bossersimon/stm32-audio-DSP/documents/86AjS.png

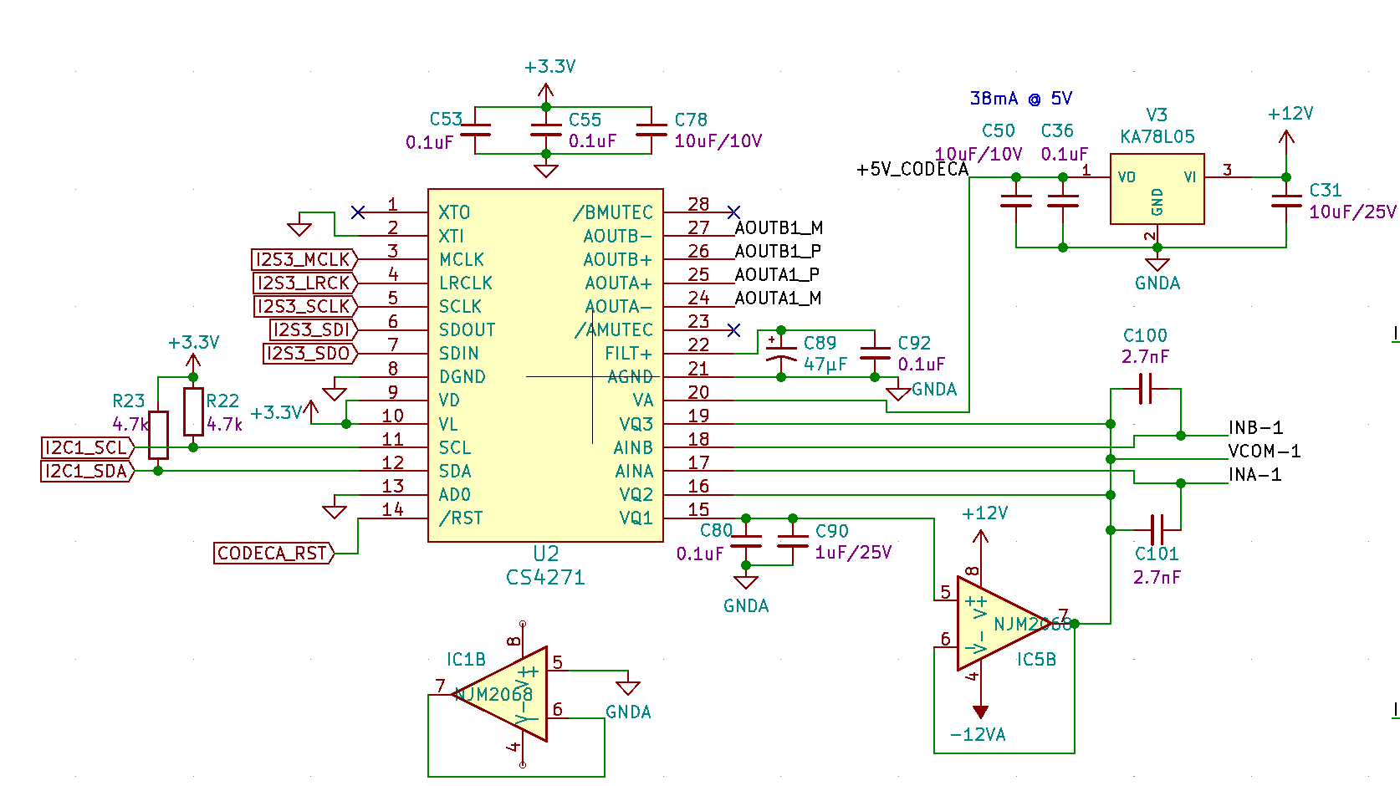
documents/86AjS.png
