bossersimon/stm32-audio-DSP/kicad/first.kicad_pcb

## KiCad design kicad/first.kicad_pcb (2026-11-02)

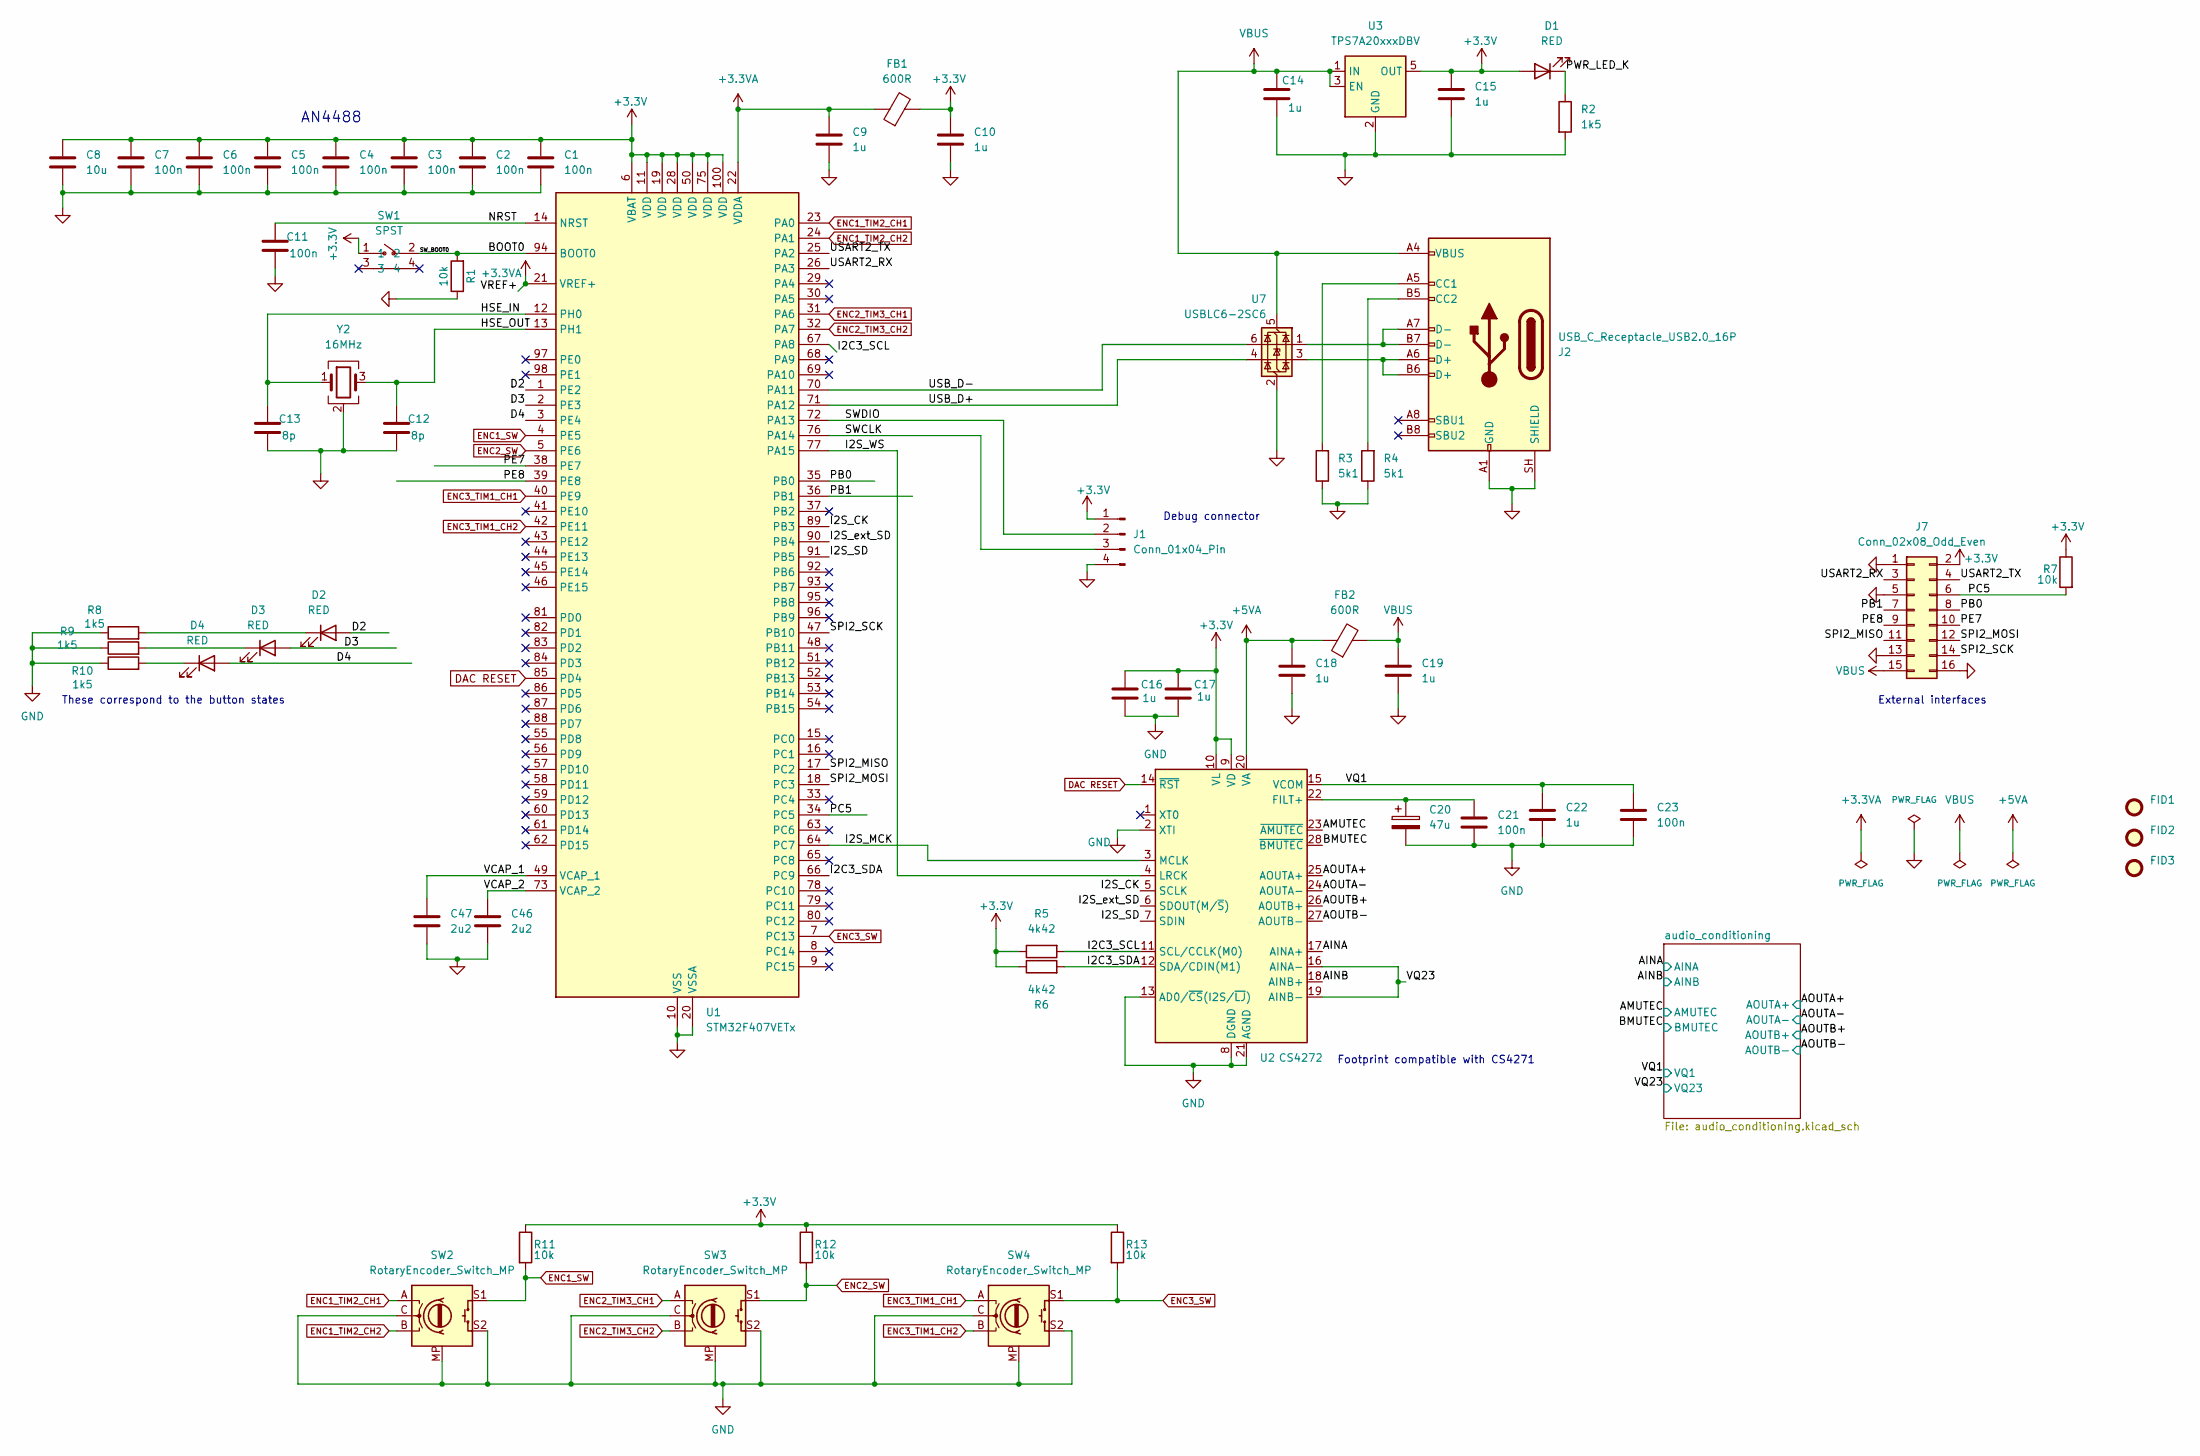
[picture p2: schematic first.kicad_sch]

Parts:
C1, C2, C3, C4, C5, C6, C7, C11, C21, C23: 100n; C_0402_1005Metric
C8: 10u; C_0603_1608Metric
C9, C10, C14, C15, C16, C17, C18, C19, C22: 1u; C_0402_1005Metric
C12, C13: 8p; C_0402_1005Metric
C20: 47u; CP_Elec_4x5.4
C46, C47: 2u2; C_0402_1005Metric
D1, D2, D3, D4: RED; LED_0603_1608Metric
FB1, FB2: 600R; L_0603_1608Metric
FID1, FID2, FID3: Fiducial; Fiducial_1mm_Mask3mm
J1: Conn_01x04_Pin; PinHeader_1x04_P2.54mm_Vertical
J2: USB_C_Receptacle_USB2.0_16P; USB_C_Receptacle_G-Switch_GT-USB-7010ASV
J7: Conn_02x08_Odd_Even; PinHeader_2x08_P2.54mm_Vertical
R1, R7, R11, R12, R13: 10k; R_0402_1005Metric
R2, R8, R9, R10: 1k5; R_0402_1005Metric
R3, R4: 5k1; R_0402_1005Metric
R5, R6: 4k42; R_0402_1005Metric
SW1: SPST; SW-SMD_TC-S3601-3.5-260G-F0.6; MPN TC-S3601-3.5-260G-F0.6; LCSC Part C49101620
SW2, SW3, SW4: RotaryEncoder_Switch_MP; RotaryEncoder_Alps_EC11E-Switch_Vertical_H20mm
U1: STM32F407VETx; LQFP-100_14x14mm_P0.5mm
U2: CS4272; TSSOP-28_4.4x9.7mm_P0.65mm
U3: TPS7A20xxxDBV; SOT-23-5
U7: USBLC6-2SC6; SOT-23-6
Y2: 16MHz; Crystal_SMD_3225-4Pin_3.2x2.5mm

Connections:
+3.3V: C1.1, C2.1, C3.1, C4.1, C5.1, C6.1, C7.1, C8.1, C10.1, C15.1, C16.1, C17.1, D1.2 (A), FB1.2, J1.1, J7.2, R5.1, R6.1, R7.1, R11.1, R12.1, R13.1, SW1.1, U1.6 (VBAT), U1.11 (VDD), U1.19 (VDD), U1.28 (VDD), U1.50 (VDD), U1.75 (VDD), U1.100 (VDD), U2.9 (VD), U2.10 (VL), U3.5 (OUT)
+3.3VA: C9.1, FB1.1, U1.21 (VREF+), U1.22 (VDDA)
+5VA: C18.1, FB2.1, U2.20 (VA); also elsewhere on the board
/AINA: U2.17 (AINA+); also elsewhere on the board
/AINB: U2.18 (AINB+); also elsewhere on the board
/AMUTEC: U2.23 (~AMUTEC); also elsewhere on the board
/AOUTA+: U2.25 (AOUTA+); also elsewhere on the board
/AOUTA-: U2.24 (AOUTA-); also elsewhere on the board
/AOUTB+: U2.26 (AOUTB+); also elsewhere on the board
/AOUTB-: U2.27 (AOUTB-); also elsewhere on the board
/BMUTEC: U2.28 (~BMUTEC); also elsewhere on the board
/BOOT0: R1.2, SW1.2, U1.94 (BOOT0)
/D2: D2.2 (A), U1.1 (PE2)
/D3: D3.2 (A), U1.2 (PE3)
/D4: D4.2 (A), U1.3 (PE4)
/HSE_IN: C13.1, U1.12 (PH0), Y2.1
/HSE_OUT: C12.1, U1.13 (PH1), Y2.3
/I2C3_SCL: R5.2, U1.67 (PA8), U2.11 (SCL/CCLK(M0))
/I2C3_SDA: R6.2, U1.66 (PC9), U2.12 (SDA/CDIN(M1))
/I2S_CK: U1.89 (PB3), U2.5 (SCLK)
/I2S_MCK: U1.64 (PC7), U2.3 (MCLK)
/I2S_SD: U1.91 (PB5), U2.7 (SDIN)
/I2S_WS: U1.77 (PA15), U2.4 (LRCK)
/I2S_ext_SD: U1.90 (PB4), U2.6 (SDOUT(M/~S))
/NRST: C11.1, U1.14 (NRST)
/PB0: J7.8, U1.35 (PB0)
/PB1: J7.7, U1.36 (PB1)
/PC5: J7.6, R7.2, U1.34 (PC5)
/PE7: J7.10, U1.38 (PE7)
/PE8: J7.9, U1.39 (PE8)
/PWR_LED_K: D1.1 (K), R2.1
/SPI2_MISO: J7.11, U1.17 (PC2)
/SPI2_MOSI: J7.12, U1.18 (PC3)
/SPI2_SCK: J7.14, U1.47 (PB10)
/SWCLK: J1.3, U1.76 (PA14)
/SWDIO: J1.2, U1.72 (PA13)
/USART2_RX: J7.3, U1.26 (PA3)
/USART2_TX: J7.4, U1.25 (PA2)
/USB_D+: U1.71 (PA12), U7.4 (I/O2)
/USB_D-: U1.70 (PA11), U7.6 (I/O1)
/VCAP_1: C47.2, U1.49 (VCAP_1)
/VCAP_2: C46.2, U1.73 (VCAP_2)
/VQ1: C22.1, C23.1, U2.15 (VCOM); also elsewhere on the board
/VQ23: U2.16 (AINA-), U2.19 (AINB-); also elsewhere on the board
DAC RESET: U1.85 (PD4), U2.14 (~RST)
ENC1_SW: R11.2, SW2.S1, U1.4 (PE5)
ENC1_TIM2_CH1: SW2.A, U1.23 (PA0)
ENC1_TIM2_CH2: SW2.B, U1.24 (PA1)
ENC2_SW: R12.2, SW3.S1, U1.5 (PE6)
ENC2_TIM3_CH1: SW3.A, U1.31 (PA6)
ENC2_TIM3_CH2: SW3.B, U1.32 (PA7)
ENC3_SW: R13.2, SW4.S1, U1.7 (PC13)
ENC3_TIM1_CH1: SW4.A, U1.40 (PE9)
ENC3_TIM1_CH2: SW4.B, U1.42 (PE11)
GND: C1.2, C2.2, C3.2, C4.2, C5.2, C6.2, C7.2, C8.2, C9.2, C10.2, C11.2, C12.2, C13.2, C14.2, C15.2, C16.2, C17.2, C18.2, C19.2, C20.2, C21.2, C22.2, C23.2, C46.1, C47.1, J1.4, J2.A1 (GND), J2.A12 (GND), J2.B1 (GND), J2.B12 (GND), J2.SH (SHIELD), J7.1, J7.5, J7.13, J7.16, R1.1, R2.2, R3.1, R4.1, R8.1, R9.1, R10.1, SW2.C, SW2.MP, SW2.S2, SW3.C, SW3.MP, SW3.S2, SW4.C, SW4.MP, SW4.S2, U1.10 (VSS), U1.20 (VSSA), U1.27 (VSS), U1.74 (VSS), U1.99 (VSS), U2.2 (XTI), U2.8 (DGND), U2.13 (AD0/~CS(I2S/~LJ)), U2.21 (AGND), U3.2 (GND), U7.2 (GND), Y2.2 (G), Y2.4 (G); also elsewhere on the board
unnamed: D2.1 (K), R8.2
unnamed: D3.1 (K), R9.2
unnamed: D4.1 (K), R10.2
unnamed: J2.A5 (CC1), R3.2
unnamed: J2.B5 (CC2), R4.2
unnamed: J2.A6 (D+), J2.B6 (D+), U7.3 (I/O2)
unnamed: J2.A7 (D-), J2.B7 (D-), U7.1 (I/O1)
unnamed: C20.1, C21.1, U2.22 (FILT+)
VBUS: C14.1, C19.1, FB2.2, J2.A4 (VBUS), J2.A9 (VBUS), J2.B4 (VBUS), J2.B9 (VBUS), J7.15, U3.1 (IN), U3.3 (EN), U7.5 (VBUS)

Notes on the sheet:
AN4488
These correspond to the button states
Footprint compatible with CS4271
Debug connector
External interfaces

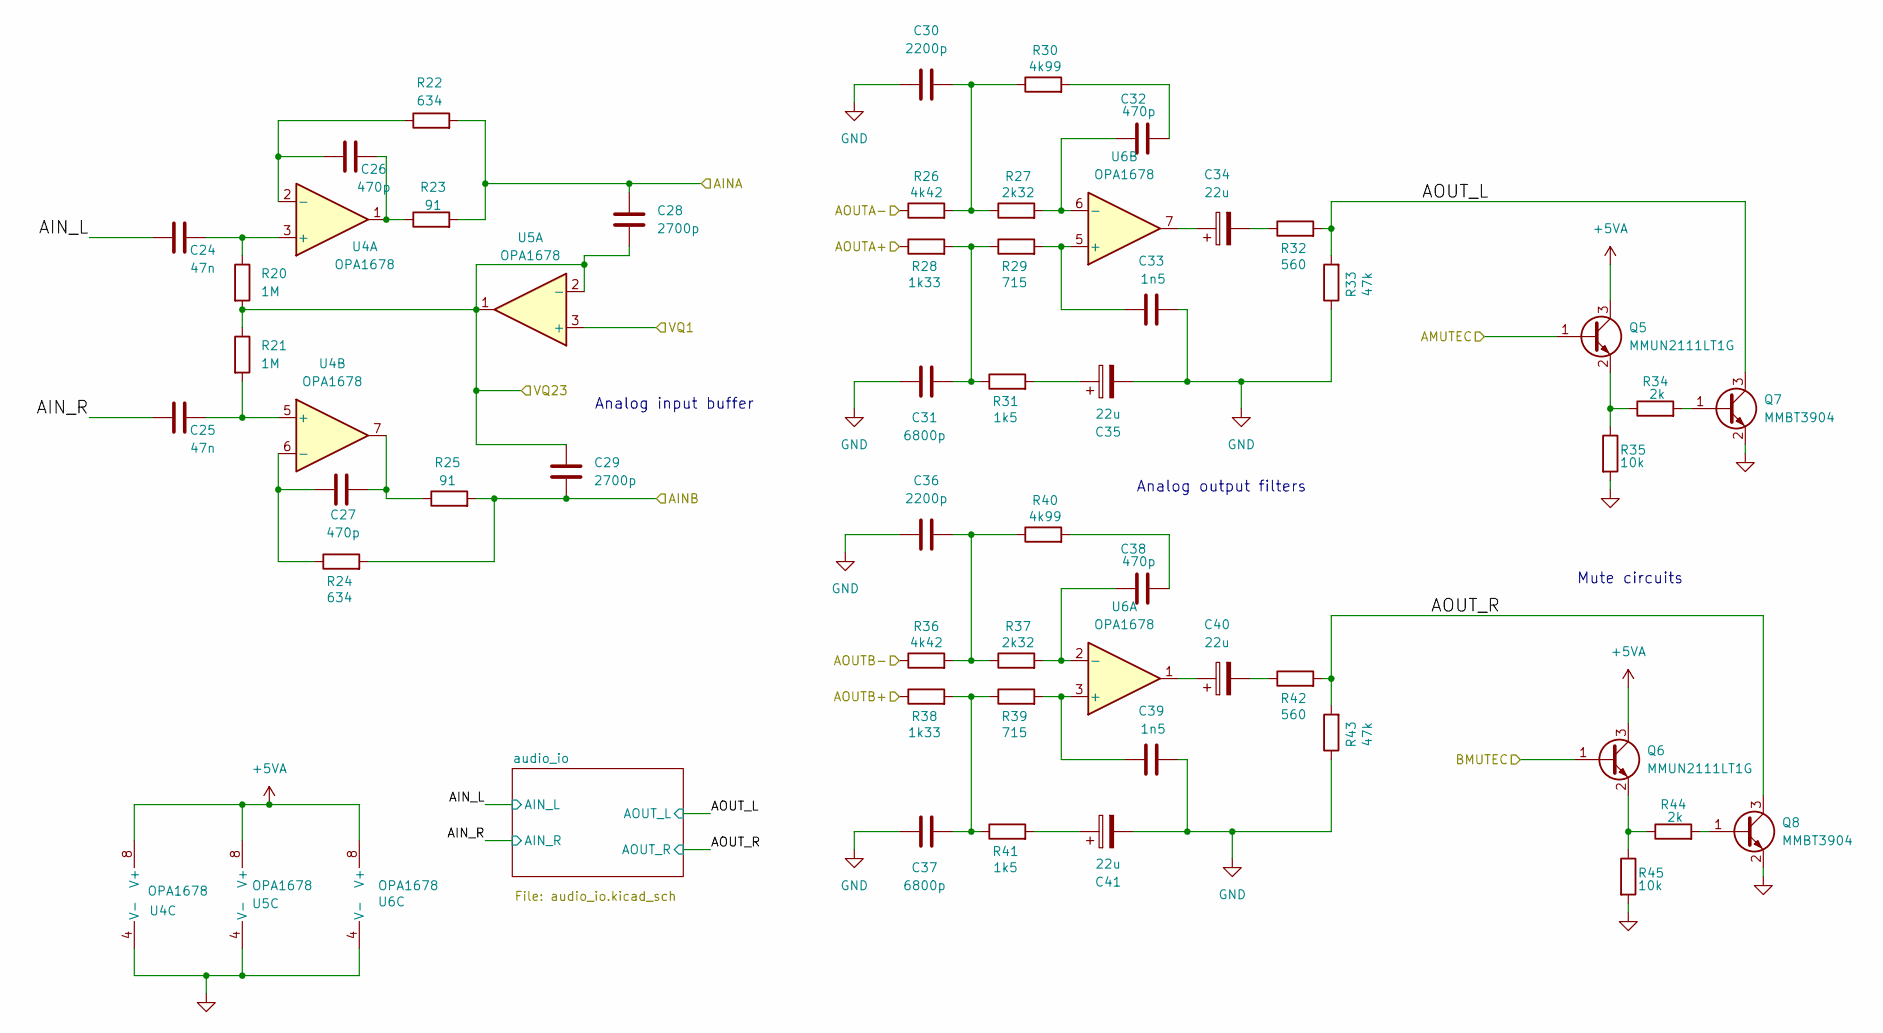
[picture p3: schematic audio_conditioning.kicad_sch]

Parts:
C24, C25: 47n; C_0805_2012Metric
C26, C27, C32, C38: 470p; C_0402_1005Metric
C28, C29: 2700p; C_0603_1608Metric
C30, C36: 2200p; C_0603_1608Metric
C31, C37: 6800p; C_0603_1608Metric
C33, C39: 1n5; C_0603_1608Metric
C34, C35, C40, C41: 22u; CP_Elec_4x5.4
Q5, Q6: MMUN2111LT1G; SOT-23
Q7, Q8: MMBT3904; SOT-23
R20, R21: 1M; R_0402_1005Metric
R22, R24: 634; R_0402_1005Metric
R23, R25: 91; R_0402_1005Metric
R26, R36: 4k42; R_0402_1005Metric
R27, R37: 2k32; R_0402_1005Metric
R28, R38: 1k33; R_0402_1005Metric
R29, R39: 715; R_0402_1005Metric
R30, R40: 4k99; R_0402_1005Metric
R31, R41: 1k5; R_0402_1005Metric
R32, R42: 560; R_0402_1005Metric
R33, R43: 47k; R_0402_1005Metric
R34, R44: 2k; R_0402_1005Metric
R35, R45: 10k; R_0402_1005Metric
U4, U5, U6: OPA1678; SOIC-8_3.9x4.9mm_P1.27mm

Connections:
+5VA: Q5.3 (C), Q6.3 (C), U4.8 (V+), U5.8 (V+), U6.8 (V+); also elsewhere on the board
/AINA: C28.1, R22.2, R23.2; also elsewhere on the board
/AINB: C29.2, R24.2, R25.2; also elsewhere on the board
/AMUTEC: Q5.1 (B); also elsewhere on the board
/AOUTA+: R28.1; also elsewhere on the board
/AOUTA-: R26.1; also elsewhere on the board
/AOUTB+: R38.1; also elsewhere on the board
/AOUTB-: R36.1; also elsewhere on the board
/BMUTEC: Q6.1 (B); also elsewhere on the board
/VQ1: U5.3 (+); also elsewhere on the board
/VQ23: C28.2, C29.1, R20.2, R21.1, U5.1, U5.2 (-); also elsewhere on the board
/audio_conditioning/AIN_L: C24.2; also elsewhere on the board
/audio_conditioning/AIN_R: C25.2; also elsewhere on the board
/audio_conditioning/AOUT_L: Q7.3 (C), R32.2, R33.2; also elsewhere on the board
/audio_conditioning/AOUT_R: Q8.3 (C), R42.2, R43.2; also elsewhere on the board
GND: C30.2, C31.2, C33.1, C35.2, C36.2, C37.2, C39.1, C41.2, Q7.2 (E), Q8.2 (E), R33.1, R35.2, R43.1, R45.2, U4.4 (V-), U5.4 (V-), U6.4 (V-); also elsewhere on the board
unnamed: C26.1, R23.1, U4.1
unnamed: C27.1, R25.1, U4.7
unnamed: C30.1, R26.2, R27.1, R30.1
unnamed: C31.1, R28.2, R29.1, R31.1
unnamed: C32.1, R30.2
unnamed: C34.1, U6.7
unnamed: C34.2, R32.1
unnamed: C35.1, R31.2
unnamed: C36.1, R36.2, R37.1, R40.1
unnamed: C37.1, R38.2, R39.1, R41.1
unnamed: C38.1, R40.2
unnamed: C40.1, U6.1
unnamed: C40.2, R42.1
unnamed: C41.1, R41.2
unnamed: Q5.2 (E), R34.1, R35.1
unnamed: Q6.2 (E), R44.1, R45.1
unnamed: Q7.1 (B), R34.2
unnamed: Q8.1 (B), R44.2
unnamed: C24.1, R20.1, U4.3 (+)
unnamed: C26.2, R22.1, U4.2 (-)
unnamed: C25.1, R21.2, U4.5 (+)
unnamed: C27.2, R24.1, U4.6 (-)
unnamed: C39.2, R39.2, U6.3 (+)
unnamed: C38.2, R37.2, U6.2 (-)
unnamed: C33.2, R29.2, U6.5 (+)
unnamed: C32.2, R27.2, U6.6 (-)

Notes on the sheet:
Analog output filters
Analog input buffer
Mute circuits

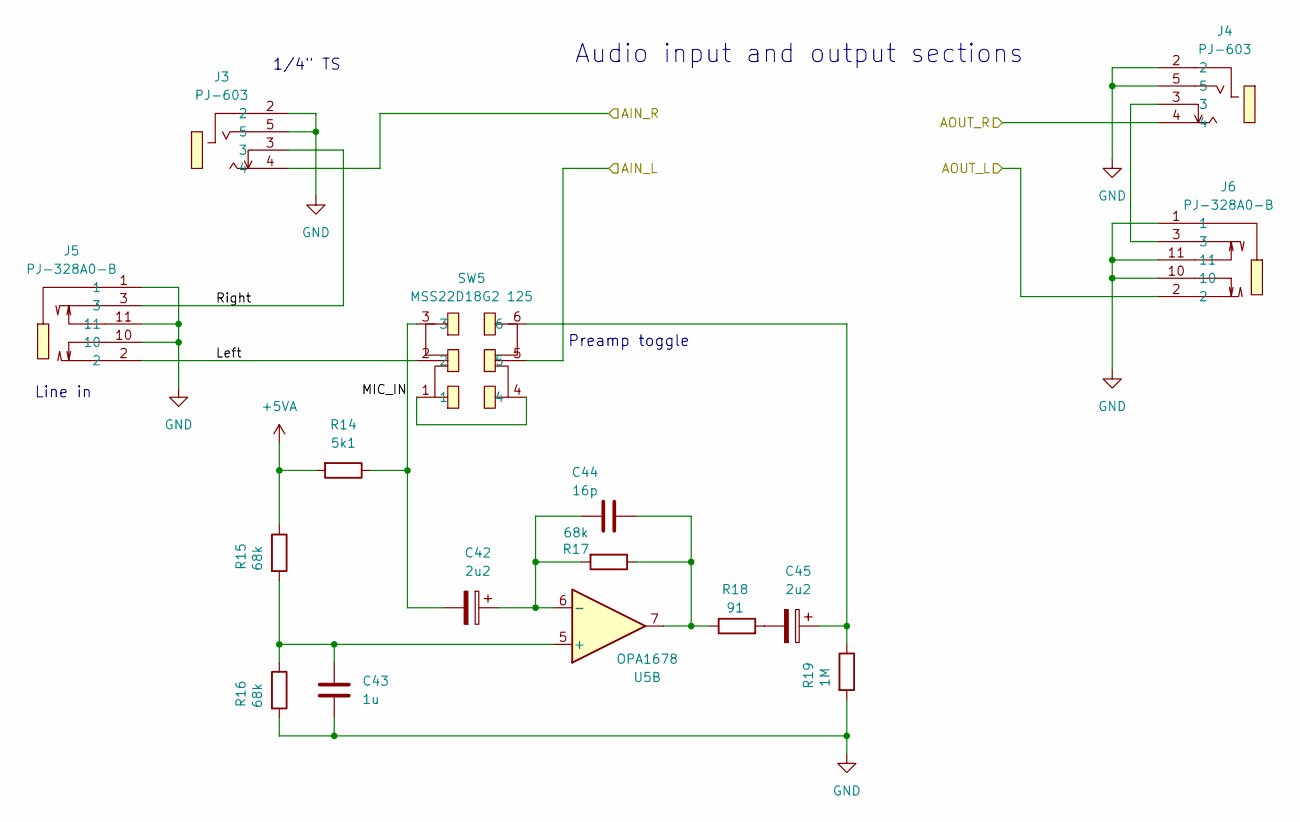
[picture p4: schematic audio_io.kicad_sch]

Parts:
C42, C45: 2u2; CP_Elec_4x5.4
C43: 1u; C_0402_1005Metric
C44: 16p; C_0402_1005Metric
J3, J4: PJ-603; AUDIO-TH_PJ-603; MPN PJ-603环保; LCSC Part C309272
J5, J6: PJ-328A0-B; AUDIO-TH_PJ-328A0-B; MPN PJ-328A0-B; LCSC Part C381129
R14: 5k1; R_0402_1005Metric
R15, R16, R17: 68k; R_0402_1005Metric
R18: 91; R_0402_1005Metric
R19: 1M; R_0402_1005Metric
SW5: MSS22D18G2 125; SW-TH_SHOU_MSS22D18G2; MPN MSS22D18G2 125; LCSC Part C2906278
U5: OPA1678; SOIC-8_3.9x4.9mm_P1.27mm

Connections:
+5VA: R14.2, R15.1; also elsewhere on the board
/audio_conditioning/AIN_L: SW5.5; also elsewhere on the board
/audio_conditioning/AIN_R: J3.4; also elsewhere on the board
/audio_conditioning/AOUT_L: J6.2; also elsewhere on the board
/audio_conditioning/AOUT_R: J4.4; also elsewhere on the board
/audio_conditioning/audio_io/Left: J5.2, SW5.2
/audio_conditioning/audio_io/MIC_IN: C42.2, R14.1, SW5.3
/audio_conditioning/audio_io/Right: J3.3, J5.3
GND: C43.2, J3.2, J3.5, J4.2, J4.5, J5.1, J5.10, J5.11, J6.1, J6.10, J6.11, R16.2, R19.2; also elsewhere on the board
unnamed: C44.2, R17.1, R18.1, U5.7
unnamed: C45.1, R19.1, SW5.6
unnamed: C45.2, R18.2
unnamed: J4.3, J6.3
unnamed: SW5.1, SW5.4
unnamed: C43.1, R15.2, R16.1, U5.5 (+)
unnamed: C42.1, C44.1, R17.2, U5.6 (-)

Notes on the sheet:
Preamp toggle
Audio input and output sections
1/4" TS
Line in

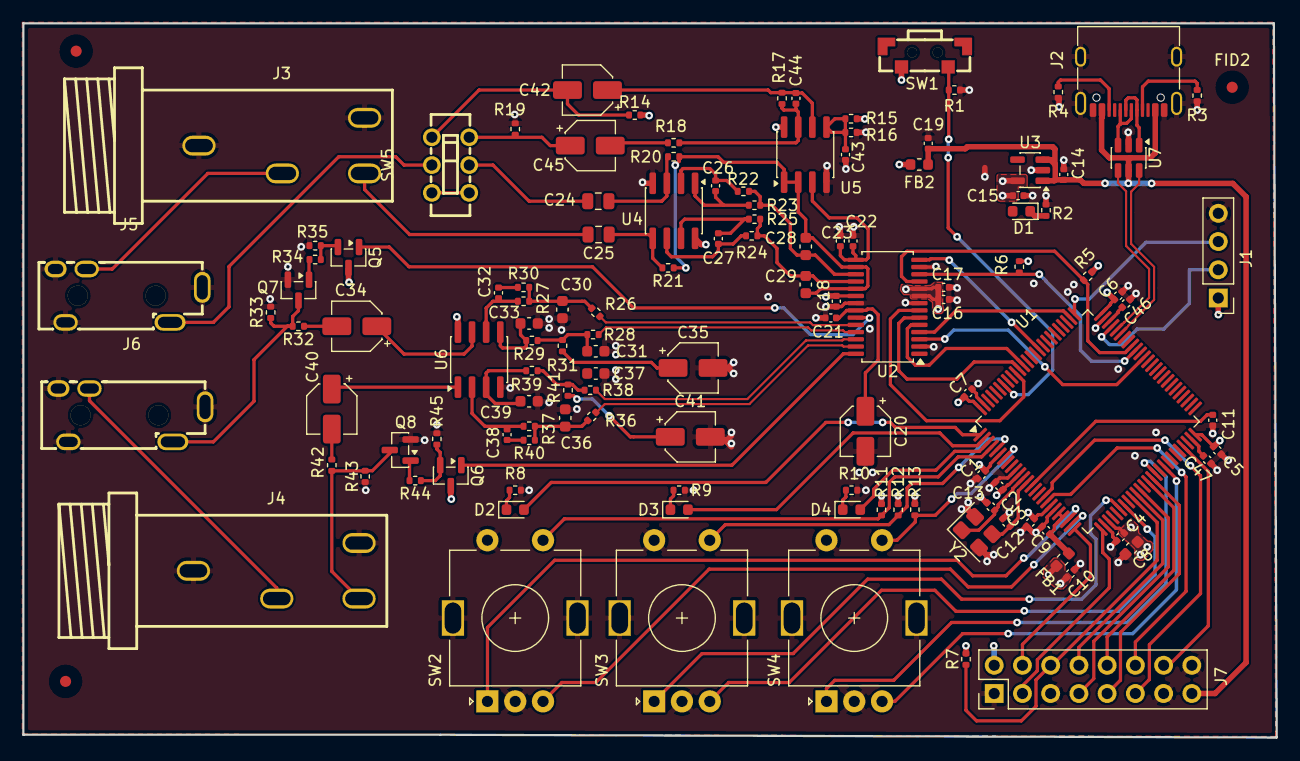
[picture p5: board first.kicad_pcb from above]

Board: 4 copper layers, 112.8 x 64.2 mm, 125 parts (0 on the bottom side), 104 nets.
