bossersimon/stm32-audio-DSP/Core/Src/main.c

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
/* Includes ------------------------------------------------------------------*/
#include "main.h"
#include "usb_device.h"

/* USER CODE BEGIN Includes */
#include "math.h"
#include <stdint.h>
#include "audio_sample.c"
/* USER CODE END Includes */

/* USER CODE BEGIN PD */
#define BUFFER_SIZE 128 // double buffer size
#define CAPACITY 1024   // circular buffer size
#define WINDOW_SIZE 256 // FFT size
#define AUDIO_SMPLRT 48000 // audio sample rate (temporary)
#define DAC_ADDR (0x4AU << 1)

#ifndef M_PI
#    define M_PI 3.14159265358979323846
#endif
/* USER CODE END PD */

ADC_HandleTypeDef hadc1;

I2C_HandleTypeDef hi2c1;
I2C_HandleTypeDef hi2c2;

I2S_HandleTypeDef hi2s3;
DMA_HandleTypeDef hdma_spi3_tx;

SPI_HandleTypeDef hspi2;

TIM_HandleTypeDef htim2;
TIM_HandleTypeDef htim3;
TIM_HandleTypeDef htim4;

UART_HandleTypeDef huart3;

/* USER CODE BEGIN PV */
//int16_t adcData[BUFFER_SIZE]; // buffers to hold DMA read/writes
int16_t dacData[BUFFER_SIZE];
//static volatile int16_t *adcBufPtr; // pointers for DMA
static volatile int16_t *dacBufPtr = &dacData[0];

static float phase; // generated sinusoid phase variable
static float dp;

static int16_t inBuf[CAPACITY];   // input/output circular buffers
static int16_t outBuf[CAPACITY];
uint8_t dataReadyFlag;

static volatile int16_t *inBufHead; // circular buffer pointers
static volatile int16_t *inBufTail;
static int16_t *inBufEnd;

static volatile int16_t *outBufHead;
static volatile int16_t *outBufTail;
static int16_t *outBufEnd;

static int inDataReadyFlag = 0;  // read/writes when there are enough samples in
static int outDataReadyFlag = 0; // the circular buffers

static uint16_t* audiosample = AUDIO_SAMPLE;
const size_t AUDIO_LENGTH = sizeof(AUDIO_SAMPLE) / sizeof(AUDIO_SAMPLE[0]);

/* USER CODE END PV */

void SystemClock_Config(void);
static void MX_GPIO_Init(void);
static void MX_DMA_Init(void);
static void MX_I2C1_Init(void);
static void MX_I2S3_Init(void);
static void MX_TIM2_Init(void);
static void MX_TIM3_Init(void);
static void MX_TIM4_Init(void);
static void MX_ADC1_Init(void);
static void MX_I2C2_Init(void);
static void MX_SPI2_Init(void);
static void MX_USART3_UART_Init(void);
/* USER CODE BEGIN PFP */
void process_block();
/* USER CODE END PFP */

/* USER CODE BEGIN 0 */

// half full
/*
void HAL_I2SEx_TxRxHalfCpltCallback(I2S_HandleTypeDef *hi2s) {

  adcBufPtr = &adcData[0];
  dacBufPtr = &dacData[0];

  dataReadyFlag = 1;
}
*/
// other half full
/*
void HAL_I2SEx_TxRxCpltCallback(I2S_HandleTypeDef *hi2s) {

    adcBufPtr = &adcData[BUFFER_SIZE/2];
    dacBufPtr = &dacData[BUFFER_SIZE/2];

    dataReadyFlag = 1;
}
*/
void HAL_I2S_TxCpltCallback(I2S_HandleTypeDef *hi2s) {
    //adcBufPtr = &adcData[BUFFER_SIZE/2];
    dacBufPtr = &dacData[BUFFER_SIZE/2];

    dataReadyFlag = 1;
}

void HAL_I2S_TxHalfCpltCallback(I2S_HandleTypeDef *hi2s) {
  //adcBufPtr = &adcData[0];
  dacBufPtr = &dacData[0];

  dataReadyFlag = 1;

}

void process_block() {

  static float leftIn, leftOut;
  static float rightIn, rightOut;

  if (audiosample >= (AUDIO_SAMPLE + AUDIO_LENGTH)) {
    audiosample = AUDIO_SAMPLE;
  }
  
  for(int i = 0; i < (BUFFER_SIZE/2); i += 2) {
    //leftIn = (float)adcBufPtr[i]/ 32767.0f;
    //rightIn = (float)adcBufPtr[i+1]/ 32767.0f;

    leftIn = audiosample[i];
    rightIn = audiosample[i+1];

    leftOut = leftIn;
    rightOut = rightIn;

    dacBufPtr[i] = leftOut;
    dacBufPtr[i+1] =  rightOut;
  }
  audiosample = audiosample + (BUFFER_SIZE/2);
  dataReadyFlag = 0;
}

/* USER CODE END 0 */

/**
  * @brief  The application entry point.
  * @retval int
  */
int main(void)
{

  /* MCU Configuration--------------------------------------------------------*/

  /* Reset of all peripherals, Initializes the Flash interface and the Systick. */
  HAL_Init();

  /* Configure the system clock */
  SystemClock_Config();

  /* Initialize all configured peripherals */
  MX_GPIO_Init();
  MX_DMA_Init();
  MX_I2C1_Init();
  MX_I2S3_Init();
  MX_USB_DEVICE_Init();
  MX_TIM2_Init();
  MX_TIM3_Init();
  MX_TIM4_Init();
  MX_ADC1_Init();
  MX_I2C2_Init();
  MX_SPI2_Init();
  MX_USART3_UART_Init();
  /* USER CODE BEGIN 2 */
  // starts I2S DMA streams
  //HAL_StatusTypeDef status = HAL_I2SEx_TransmitReceive_DMA(&hi2s3, (uint16_t *) dacData, (uint16_t *) NULL, BUFFER_SIZE);
  HAL_StatusTypeDef status = HAL_I2S_Transmit_DMA(&hi2s3, (uint16_t*)dacData, BUFFER_SIZE);
  uint16_t freq = 1000; // generated frequency
  dp = 2.0 * M_PI * 1000 / AUDIO_SMPLRT;
  phase = 0;
  
  cs43l22_Init(DAC_ADDR, OUTPUT_DEVICE_AUTO, 80, AUDIO_SMPLRT);
  cs43l22_Play(DAC_ADDR, NULL, 0);
  /* USER CODE END 2 */

  /* Infinite loop */
  /* USER CODE BEGIN WHILE */
  while (1)
  {
    /* USER CODE END WHILE */

    /* USER CODE BEGIN 3 */
  }
  /* USER CODE END 3 */
}

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
