bossersimon/stm32-audio-DSP/audioDSP.ioc

Mcu.UserName=STM32F407VGTx
PA0-WKUP.Signal=S_TIM2_CH1_ETR
PA1.Signal=S_TIM2_CH2
PA11.Signal=USB_OTG_FS_DM
PA12.Signal=USB_OTG_FS_DP
PA13.Signal=SYS_JTMS-SWDIO
PA14.Signal=SYS_JTCK-SWCLK
PA15.Signal=I2S3_WS
PA2.GPIO_Label=ENC1_SW
PA2.Signal=GPIO_Input
PA5.GPIO_Label=ENC2_SW
PA5.Signal=GPIO_Input
PA6.Signal=S_TIM3_CH1
PA7.Signal=S_TIM3_CH2
PA9.Signal=USB_OTG_FS_VBUS
PB0.Signal=ADCx_IN8
PB1.Signal=ADCx_IN9
PB10.Signal=I2C2_SCL
PB11.Signal=I2C2_SDA
PB13.Signal=SPI2_SCK
PB3.Signal=I2S3_CK
PB4.Signal=I2S3_ext_SD
PB5.Signal=I2S3_SD
PB8.Signal=I2C1_SCL
PB9.Signal=I2C1_SDA
PC2.Signal=SPI2_MISO
PC3.Signal=SPI2_MOSI
PC5.Signal=ADCx_IN15
PC7.Signal=I2S3_MCK
PD12.Signal=GPIO_Output
PD13.Signal=GPIO_Output
PD14.Signal=GPIO_Output
PD15.Signal=GPIO_Output
PD4.GPIO_Label=DAC RESET
PD4.Signal=GPIO_Output
PD8.Signal=USART3_TX
PD9.Signal=USART3_RX
PE10.GPIO_Label=ENC3_SW
PE10.Signal=GPIO_Input
PE11.Signal=S_TIM1_CH2
PE7.Signal=GPIO_Input
PE9.Signal=S_TIM1_CH1
PH0-OSC_IN.Signal=RCC_OSC_IN
PH1-OSC_OUT.Signal=RCC_OSC_OUT
