bossersimon/stm32-audio-DSP/Core/Inc/main.h

#define ENC2_SW_Pin GPIO_PIN_5
#define ENC2_SW_GPIO_Port GPIOA
#define DAC_RESET_Pin GPIO_PIN_4
#define DAC_RESET_GPIO_Port GPIOD
#define ENC3_SW_Pin GPIO_PIN_5
#define ENC3_SW_GPIO_Port GPIOB
