bossersimon/stm32-audio-DSP/(commit log)

2026-04-07 configured output DMA for I2S
2026-04-07 DMA buffers + pointers
2026-04-07 added DMA callbacks (empty) and started DMA stream in main
2026-04-08 edited callbacks + time and sample rate variables
2026-04-08 regenerated MX code, mainly clock and DMA I2S config
2026-04-08 generate_DMA function, replaced t with phase (not tested)
    [main.c]
2026-04-14 removed ADC for now, configured I2S TX only, moved sine generation into main
2026-04-20 disabled full duplex mode for now, added codec inits, phase variables changed to float, defined DAC I2C address
2026-05-04 Start of first schematic
    [first.kicad_pcb, first.kicad_sch]
2026-05-05 kicad folder
    [first.kicad_pcb, first.kicad_sch]
2026-05-06 added LDO
    [first.kicad_sch]
2026-05-25 audio codec + input audio buffers
    [first.kicad_sch]
2026-05-26 analog output filters
    [first.kicad_sch]
2026-05-28 working on codec supplies
    [first.kicad_sch]
2026-06-21 parts for mute control circuit, need to rethink analog power input
    [first.kicad_sch]
2026-08-23 codec analog supply filter, added mute control circuits
    [first.kicad_sch]
2026-08-23 kicad generated files
2026-08-23 descriptive text
    [first.kicad_sch]
2026-09-05 rotary encoders
    [first.kicad_sch]
2026-09-06 TIM2,3,4 encoder mode
2026-09-06 assigned timer pins, moved I2C clk and data
    [first.kicad_sch]
2026-09-07 gpio inputs for encoder switches
2026-09-07 encoder circuits, TIM and encoder switch connections
    [first.kicad_sch]
2026-09-10 added LED's for encoders
    [first.kicad_sch]
2026-09-16 kicad history
2026-09-17 new kicad version introduced some files. HSE circuit done
    [first.kicad_sch]
2026-09-20 hierarchy layer for inputs. Replaced input impedance with 1MOhm. Swapped NE5532 for wide supply range OP amp
    [first.kicad_sch]
2026-09-20 page 2. Daisy chained/switched audio inputs. Still needs mic preamp
    [untitled.kicad_sch]
2026-09-21 microphone preamp. May give up on the jumper idea and add another jack
    [untitled.kicad_sch]
2026-09-21 DPDT switch for preamp toggle instead of jumper (not sure if this is a good solution)
    [untitled.kicad_sch]
2026-09-26 assigned UART, I2C, SPI and some additional GPIOS
    [first.kicad_sch]
2026-09-26 added some extra pins in case I want them later
2026-10-09 decoupling cleanup, new LDO, I2C pullups
2026-10-10 some cleanup, output audio connectors, some capacitor changes at input buffer and preamp
2026-10-12 extra pin header, VCAP capacitors, no connect flags
2026-10-15 capacitors, resistors values+footprints added
2026-10-15 separated into 3 sheets, new usb connector + protection, ERC ok, BOM consolidation
2026-10-18 started with PCB layout. Might want to move I2S
